FrWA14/KiCad10_RP2350B_DevelopmentBoard/Image/back.png

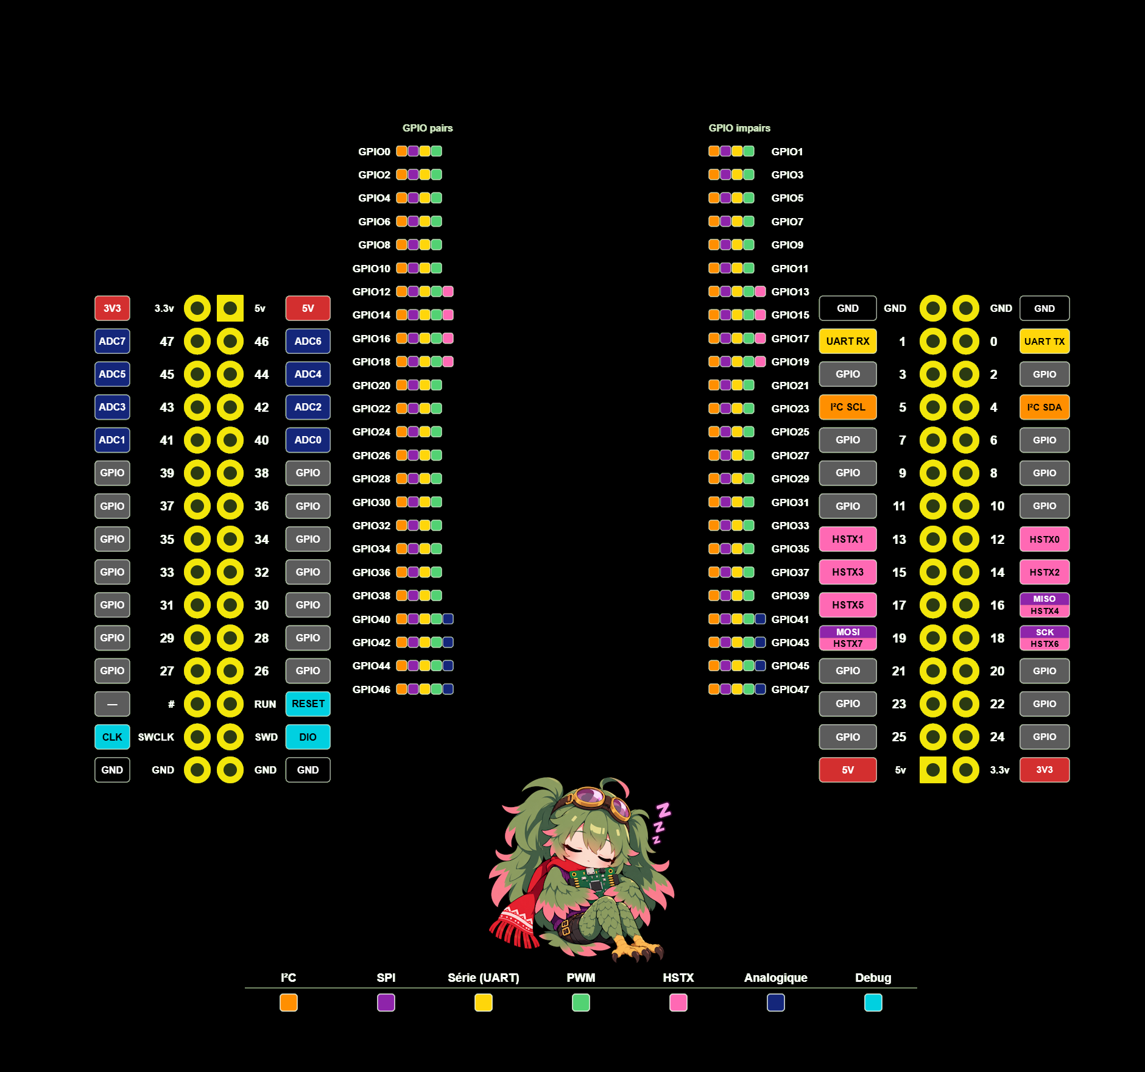
Image/back.png
