FrWA14/KiCad10_RP2350B_DevelopmentBoard/Image/PAC_Multimetre.png

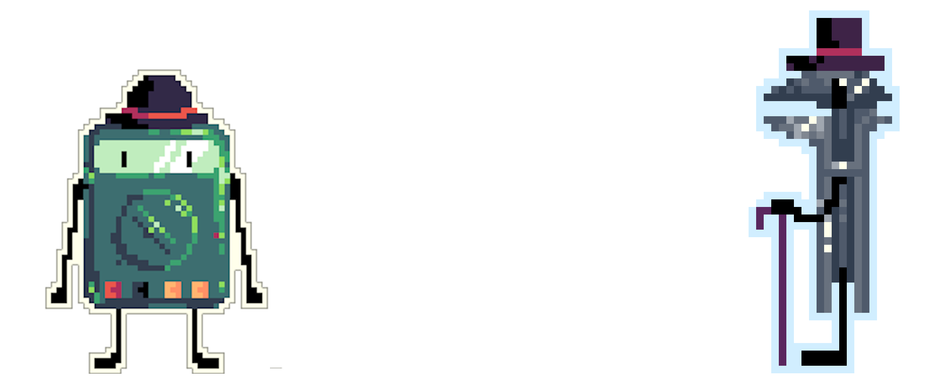
Image/PAC_Multimetre.png
