FrWA14/KiCad10_RP2350B_DevelopmentBoard/production/color_top_composite.png

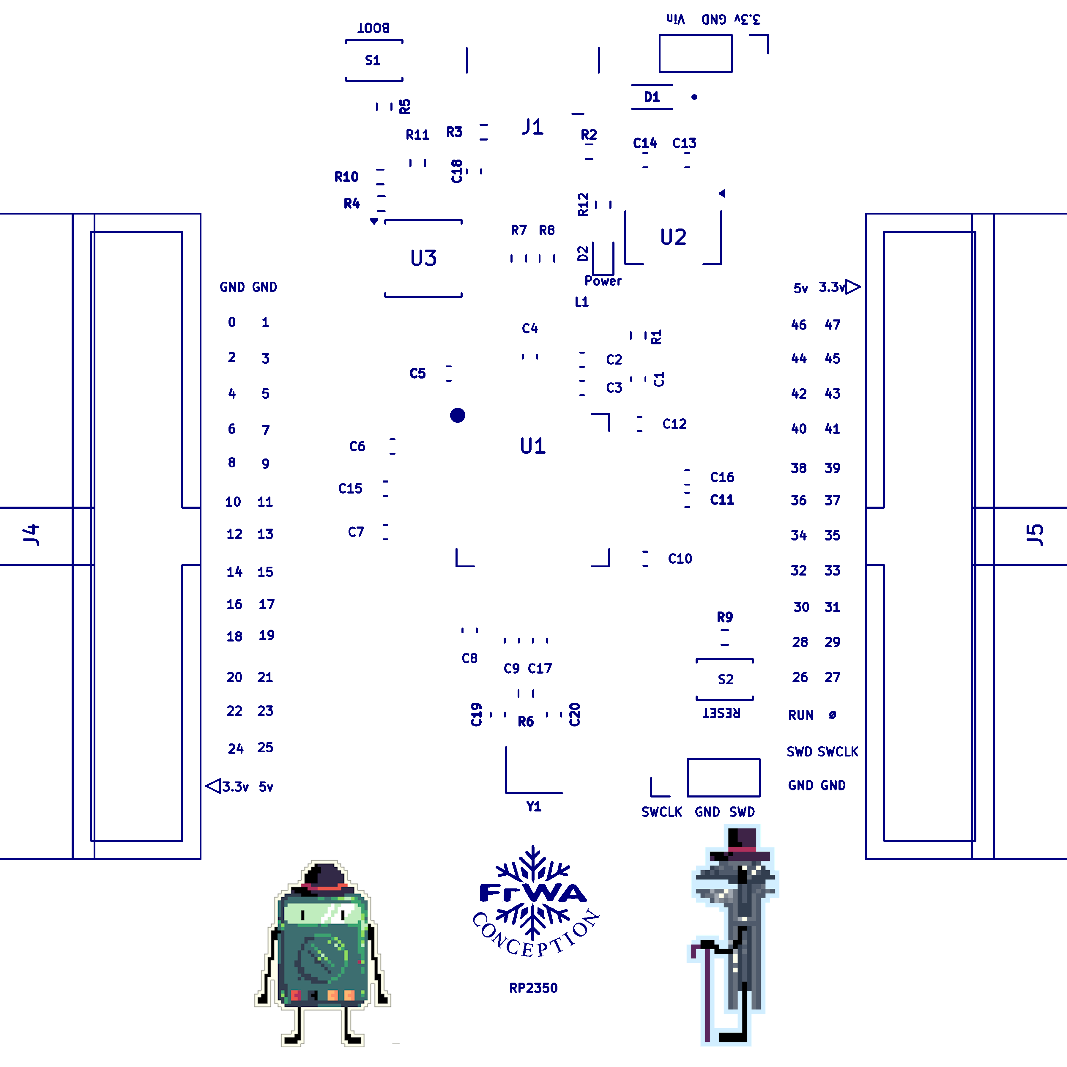
production/color_top_composite.png
