FrWA14/KiCad10_RP2350B_DevelopmentBoard/production/preview_top.png

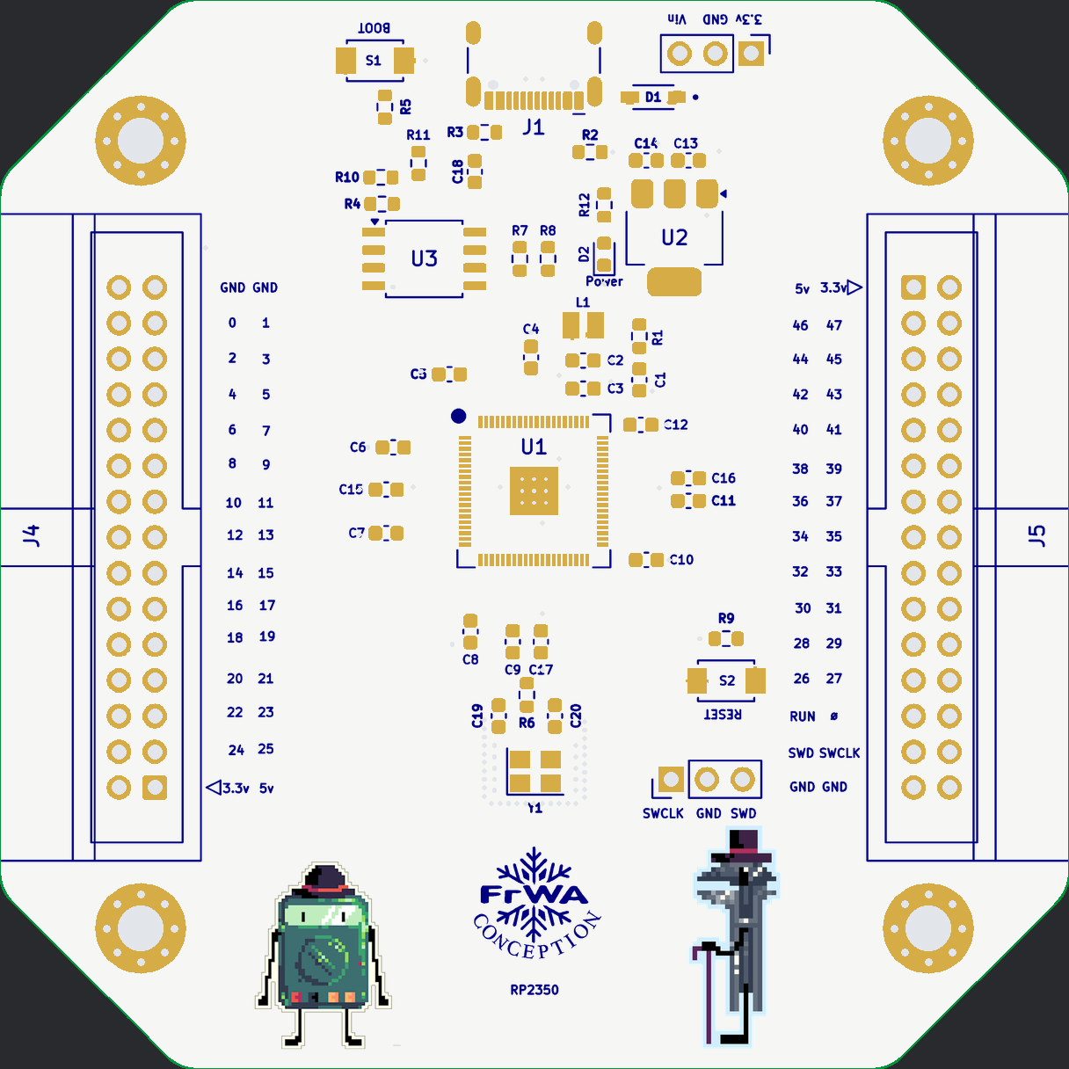
production/preview_top.png
