FrWA14/KiCad10_RP2350B_DevelopmentBoard/production/bom.csv

Designator | Footprint | Quantity | Value | LCSC Part #
C1, C17, C2, C3 | 0603 | 4 | 4.7uF | C19666
C10, C11, C12, C15, C16, C18, C4, C5, C6, C7, C8, C9 | 0603 | 12 | 100nF | C14663
C13, C14 | 0603 | 2 | 10uF | C1691
C19, C20 | 0603 | 2 | 15p | C1644
D1 | D_SOD-123_1N5819HW-7-F | 1 | 1N5819HW-7-F | C82544
D2 | 0603 | 1 | LED R | C965799
J1 | USB_C_Receptacle_HCTL_HC-TYPE-C-16P-01A | 1 | USB_C_Receptacle_USB2.0_16P | C393939
J2, J3 | PinHeader_1x03_P2.54mm_Vertical | 2 | Conn_01x03
J4, J5 | IDC-Header_2x15_P2.54mm_Horizontal_vertical | 2 | Conn_02x15_Odd_Even | C221084
L1 | 0806 | 1 | 3.3uH | C42411119
R1 | 0603 | 1 | 33 | C23140
R10, R4 | 0603 | 2 | DNF
R11 | 0603 | 1 | 0 | C21189
R12 | 0603 | 1 | 10k | C25804
R2, R3 | 0603 | 2 | 5.1K | C23186
R5, R6, R9 | 0603 | 3 | 1k | C21190
R7, R8 | 0603 | 2 | 27 | C137753
S1, S2 | SW_TS-1088-AR02016 | 2 | TS-1088-AR02016 | C720477
U1 | RP2350B_QFN-80_EP_10.573x10.573_Pitch0.4mm | 1 | RP2350B-QFN80 | C42415655
U2 | SOT-223-3_TabPin2 | 1 | AMS1117-3.3 | C6186
U3 | SOIC-8_5.23x5.23mm_P1.27mm | 1 | W25Q128JVS | C97521
Y1 | Crystal_SMD_3225-4Pin_3.2x2.5mm | 1 | Crystal_GND24 | C20625731
