FrWA14/KiCad10_RP2350B_DevelopmentBoard/RP2350.step

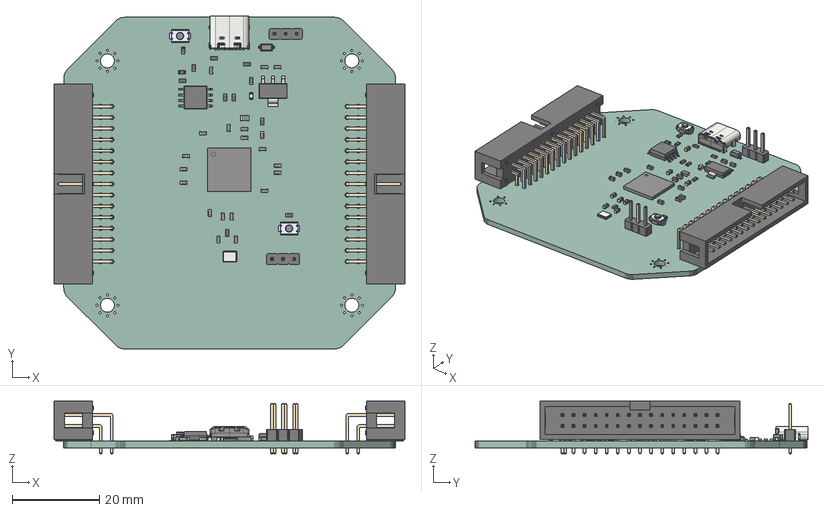
[picture p9: CAD file, 2026-10-22]
RP2350.step
80.4 x 76.3 x 12.1 mm
C_0603_1608Metric x 20
IDC_Header_2x15_P254mm_Horizontal x 2
PinHeader_1x03_P254mm_Vertical x 2
R_0603_1608Metric x 12
RP2350B-QFN80_v12
TS-1088-AR02016 x 2
SOT-223
L_0805_2012Metric
1N5819HW-7-F
Crystal_SMD_3225-4Pin_3.2x2.5mm
LED_0603_1608Metric
USB_C_Receptacle_16P_TopMnt_Horizontal_GCT_USB4105-xx-A
SOIC-8_5.3x5.3mm_P1.27mm
RP2350_PCB
