FrWA14/KiCad10_RP2350B_DevelopmentBoard/(list of files, cad)

Other CAD files:
RP2350.stl
