FrWA14/KiCad10_RP2350B_DevelopmentBoard/(list of files, drawings)

Other design files:
freerouting.dsn
