FrWA14/KiCad10_RP2350B_DevelopmentBoard/RP2350.kicad_pcb

## KiCad design RP2350.kicad_pcb (2026-10-22)

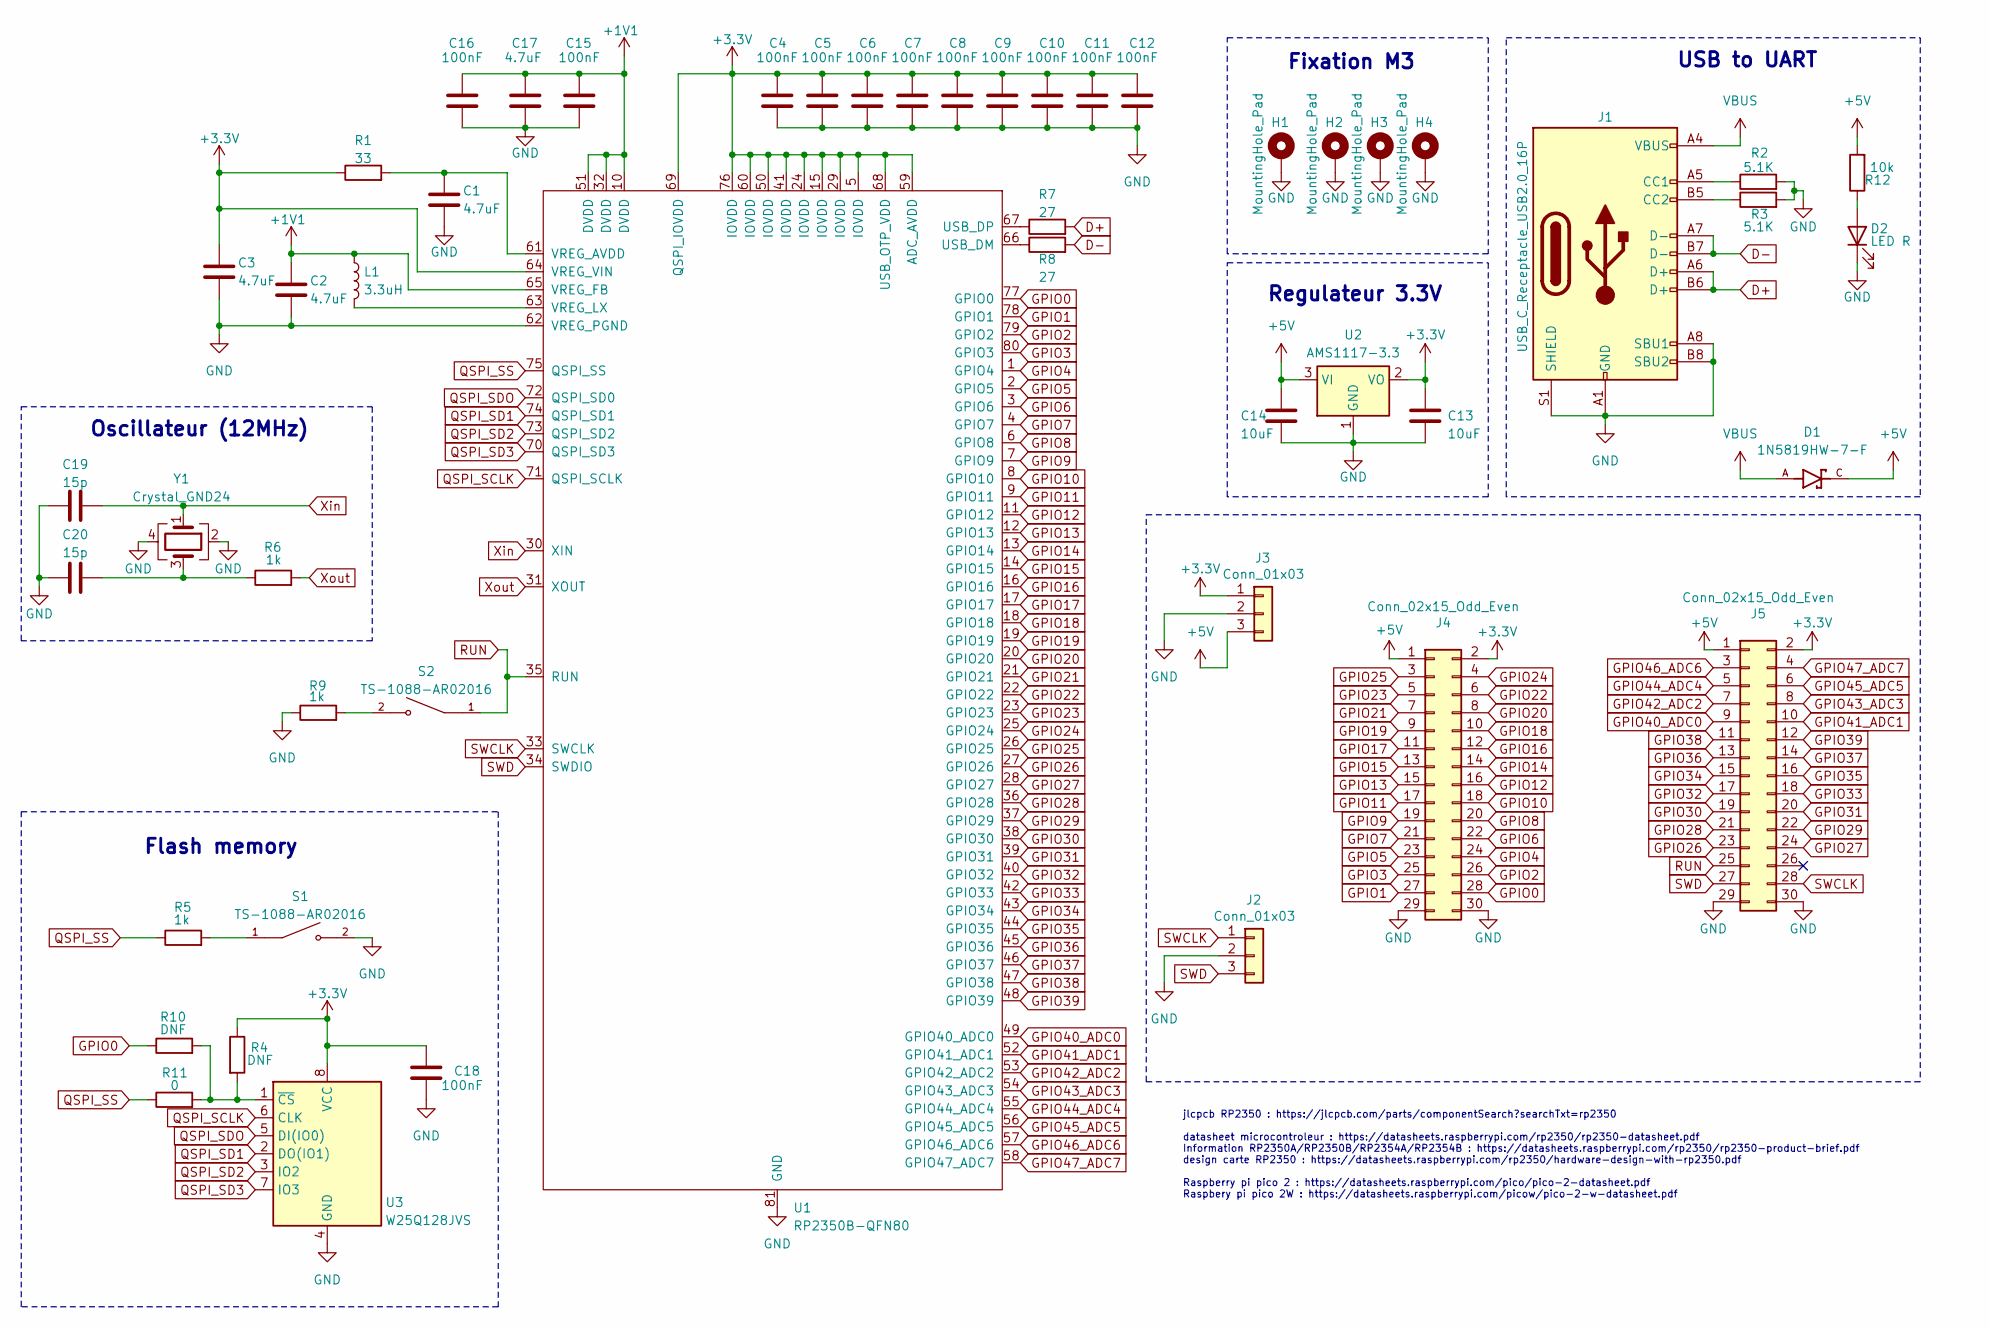
[picture p10: schematic RP2350.kicad_sch]

Parts:
C1, C2, C3, C17: 4.7uF; C_0603_1608Metric; JLCPCB Part # C19666
C4, C5, C6, C7, C8, C9, C10, C11, C12, C15, C16, C18: 100nF; C_0603_1608Metric; JLCPCB Part # C14663
C13, C14: 10uF; C_0603_1608Metric; JLCPCB Part # C1691
C19, C20: 15p; C_0603_1608Metric; JLCPCB Part # C1644
D1: 1N5819HW-7-F; D_SOD-123_1N5819HW-7-F; PARTREV 18-2; JLCPCB Part # C82544
D2: LED R; LED_0603_1608Metric; JLCPCB Part # C965799
H1, H2, H3, H4: MountingHole_Pad; MountingHole_3.2mm_M3_Pad_Via
J1: USB_C_Receptacle_USB2.0_16P; USB_C_Receptacle_HCTL_HC-TYPE-C-16P-01A; JLCPCB Part # C393939
J2, J3: Conn_01x03; PinHeader_1x03_P2.54mm_Vertical
J4, J5: Conn_02x15_Odd_Even; IDC-Header_2x15_P2.54mm_Horizontal_vertical; JLCPCB Part # C221084
L1: 3.3uH; L_0806_2016Metric; JLCPCB Part # C42411119
R1: 33; R_0603_1608Metric; JLCPCB Part # C23140
R2, R3: 5.1K; R_0603_1608Metric; JLCPCB Part # C23186
R4, R10: DNF; R_0603_1608Metric
R5, R6, R9: 1k; R_0603_1608Metric; JLCPCB Part # C21190
R7, R8: 27; R_0603_1608Metric; JLCPCB Part # C137753
R11: 0; R_0603_1608Metric; JLCPCB Part # C21189
R12: 10k; R_0603_1608Metric; JLCPCB Part # C25804
S1, S2: TS-1088-AR02016; SW_TS-1088-AR02016; PARTREV N/A; JLCPCB Part # C720477
U1: RP2350B-QFN80; RP2350B_QFN-80_EP_10.573x10.573_Pitch0.4mm; JLCPCB Part # C42415655
U2: AMS1117-3.3; SOT-223-3_TabPin2; JLCPCB Part # C6186
U3: W25Q128JVS; SOIC-8_5.23x5.23mm_P1.27mm; JLCPCB Part # C97521
Y1: Crystal_GND24; Crystal_SMD_3225-4Pin_3.2x2.5mm; JLCPCB Part # C20625731

Connections:
+1V1: C2.1, C15.1, C16.1, C17.1, L1.1, U1.10 (DVDD), U1.32 (DVDD), U1.51 (DVDD), U1.65 (VREG_FB)
+3.3V: C3.1, C4.1, C5.1, C6.1, C7.1, C8.1, C9.1, C10.1, C11.1, C12.1, C13.1, C18.1, J3.1, J4.2, J5.2, R1.1, R4.1, U1.5 (IOVDD), U1.15 (IOVDD), U1.24 (IOVDD), U1.29 (IOVDD), U1.41 (IOVDD), U1.50 (IOVDD), U1.59 (ADC_AVDD), U1.60 (IOVDD), U1.64 (VREG_VIN), U1.68 (USB_OTP_VDD), U1.69 (QSPI_IOVDD), U1.76 (IOVDD), U2.2 (VO), U3.8 (VCC)
+5V: C14.1, D1.C, J3.3, J4.1, J5.1, R12.2, U2.3 (VI)
D+: J1.A6 (D+), J1.B6 (D+), R7.2
D-: J1.A7 (D-), J1.B7 (D-), R8.2
GND: C1.2, C2.2, C3.2, C4.2, C5.2, C6.2, C7.2, C8.2, C9.2, C10.2, C11.2, C12.2, C13.2, C14.2, C15.2, C16.2, C17.2, C18.2, C19.1, C20.1, D2.1 (K), H1.1 (1_1), H2.1 (1_1), H3.1 (1_1), H4.1 (1_1), J1.A1 (GND), J1.A8 (SBU1), J1.A12 (GND), J1.B1 (GND), J1.B8 (SBU2), J1.B12 (GND), J1.S1 (SHIELD), J2.2, J3.2, J4.29, J4.30, J5.29, J5.30, R2.2, R3.2, R9.1, S1.2, U1.62 (VREG_PGND), U1.81 (GND), U2.1 (GND), U3.4 (GND), Y1.2, Y1.4
GPIO0: J4.28, R10.1, U1.77 (GPIO0)
GPIO1: J4.27, U1.78 (GPIO1)
GPIO2: J4.26, U1.79 (GPIO2)
GPIO3: J4.25, U1.80 (GPIO3)
GPIO4: J4.24, U1.1 (GPIO4)
GPIO5: J4.23, U1.2 (GPIO5)
GPIO6: J4.22, U1.3 (GPIO6)
GPIO7: J4.21, U1.4 (GPIO7)
GPIO8: J4.20, U1.6 (GPIO8)
GPIO9: J4.19, U1.7 (GPIO9)
GPIO10: J4.18, U1.8 (GPIO10)
GPIO11: J4.17, U1.9 (GPIO11)
GPIO12: J4.16, U1.11 (GPIO12)
GPIO13: J4.15, U1.12 (GPIO13)
GPIO14: J4.14, U1.13 (GPIO14)
GPIO15: J4.13, U1.14 (GPIO15)
GPIO16: J4.12, U1.16 (GPIO16)
GPIO17: J4.11, U1.17 (GPIO17)
GPIO18: J4.10, U1.18 (GPIO18)
GPIO19: J4.9, U1.19 (GPIO19)
GPIO20: J4.8, U1.20 (GPIO20)
GPIO21: J4.7, U1.21 (GPIO21)
GPIO22: J4.6, U1.22 (GPIO22)
GPIO23: J4.5, U1.23 (GPIO23)
GPIO24: J4.4, U1.25 (GPIO24)
GPIO25: J4.3, U1.26 (GPIO25)
GPIO26: J5.23, U1.27 (GPIO26)
GPIO27: J5.24, U1.28 (GPIO27)
GPIO28: J5.21, U1.36 (GPIO28)
GPIO29: J5.22, U1.37 (GPIO29)
GPIO30: J5.19, U1.38 (GPIO30)
GPIO31: J5.20, U1.39 (GPIO31)
GPIO32: J5.17, U1.40 (GPIO32)
GPIO33: J5.18, U1.42 (GPIO33)
GPIO34: J5.15, U1.43 (GPIO34)
GPIO35: J5.16, U1.44 (GPIO35)
GPIO36: J5.13, U1.45 (GPIO36)
GPIO37: J5.14, U1.46 (GPIO37)
GPIO38: J5.11, U1.47 (GPIO38)
GPIO39: J5.12, U1.48 (GPIO39)
GPIO40_ADC0: J5.9, U1.49 (GPIO40_ADC0)
GPIO41_ADC1: J5.10, U1.52 (GPIO41_ADC1)
GPIO42_ADC2: J5.7, U1.53 (GPIO42_ADC2)
GPIO43_ADC3: J5.8, U1.54 (GPIO43_ADC3)
GPIO44_ADC4: J5.5, U1.55 (GPIO44_ADC4)
GPIO45_ADC5: J5.6, U1.56 (GPIO45_ADC5)
GPIO46_ADC6: J5.3, U1.57 (GPIO46_ADC6)
GPIO47_ADC7: J5.4, U1.58 (GPIO47_ADC7)
unnamed: C20.2, R6.1, Y1.3
unnamed: D2.2 (A), R12.1
unnamed: J1.A5 (CC1), R2.1
unnamed: J1.B5 (CC2), R3.1
unnamed: R5.2, S1.1
unnamed: R9.2, S2.2
unnamed: R8.1, U1.66 (USB_DM)
unnamed: R7.1, U1.67 (USB_DP)
unnamed: C1.1, R1.2, U1.61 (VREG_AVDD)
unnamed: L1.2, U1.63 (VREG_LX)
unnamed: R4.2, R10.2, R11.2, U3.1 (~CS)
QSPI_SCLK: U1.71 (QSPI_SCLK), U3.6 (CLK)
QSPI_SD1: U1.74 (QSPI_SD1), U3.2 (DO(IO1))
QSPI_SD2: U1.73 (QSPI_SD2), U3.3 (IO2)
QSPI_SD3: U1.70 (QSPI_SD3), U3.7 (IO3)
QSPI_SDO: U1.72 (QSPI_SD0), U3.5 (DI(IO0))
QSPI_SS: R5.1, R11.1, U1.75 (QSPI_SS)
RUN: J5.25, S2.1, U1.35 (RUN)
SWCLK: J2.1, J5.28, U1.33 (SWCLK)
SWD: J2.3, J5.27, U1.34 (SWDIO)
VBUS: D1.A, J1.A4 (VBUS), J1.A9 (VBUS), J1.B4 (VBUS), J1.B9 (VBUS)
Xin: C19.2, U1.30 (XIN), Y1.1
Xout: R6.2, U1.31 (XOUT)

Notes on the sheet:
USB to UART
Flash memory
jlcpcb RP2350 : https://jlcpcb.com/parts/componentSearch?searchTxt=rp2350 datasheet microcontroleur : https://datasheets.raspberrypi.com/rp2350/rp2350-datasheet.pdf Information RP2350A/RP2350B/RP2354A/RP2354B : https://datasheets.raspberrypi.com/rp2350/rp2350-product-brief.pdf design carte RP2350 :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
Fixation M3
Regulateur 3.3V
Oscillateur (12MHz)

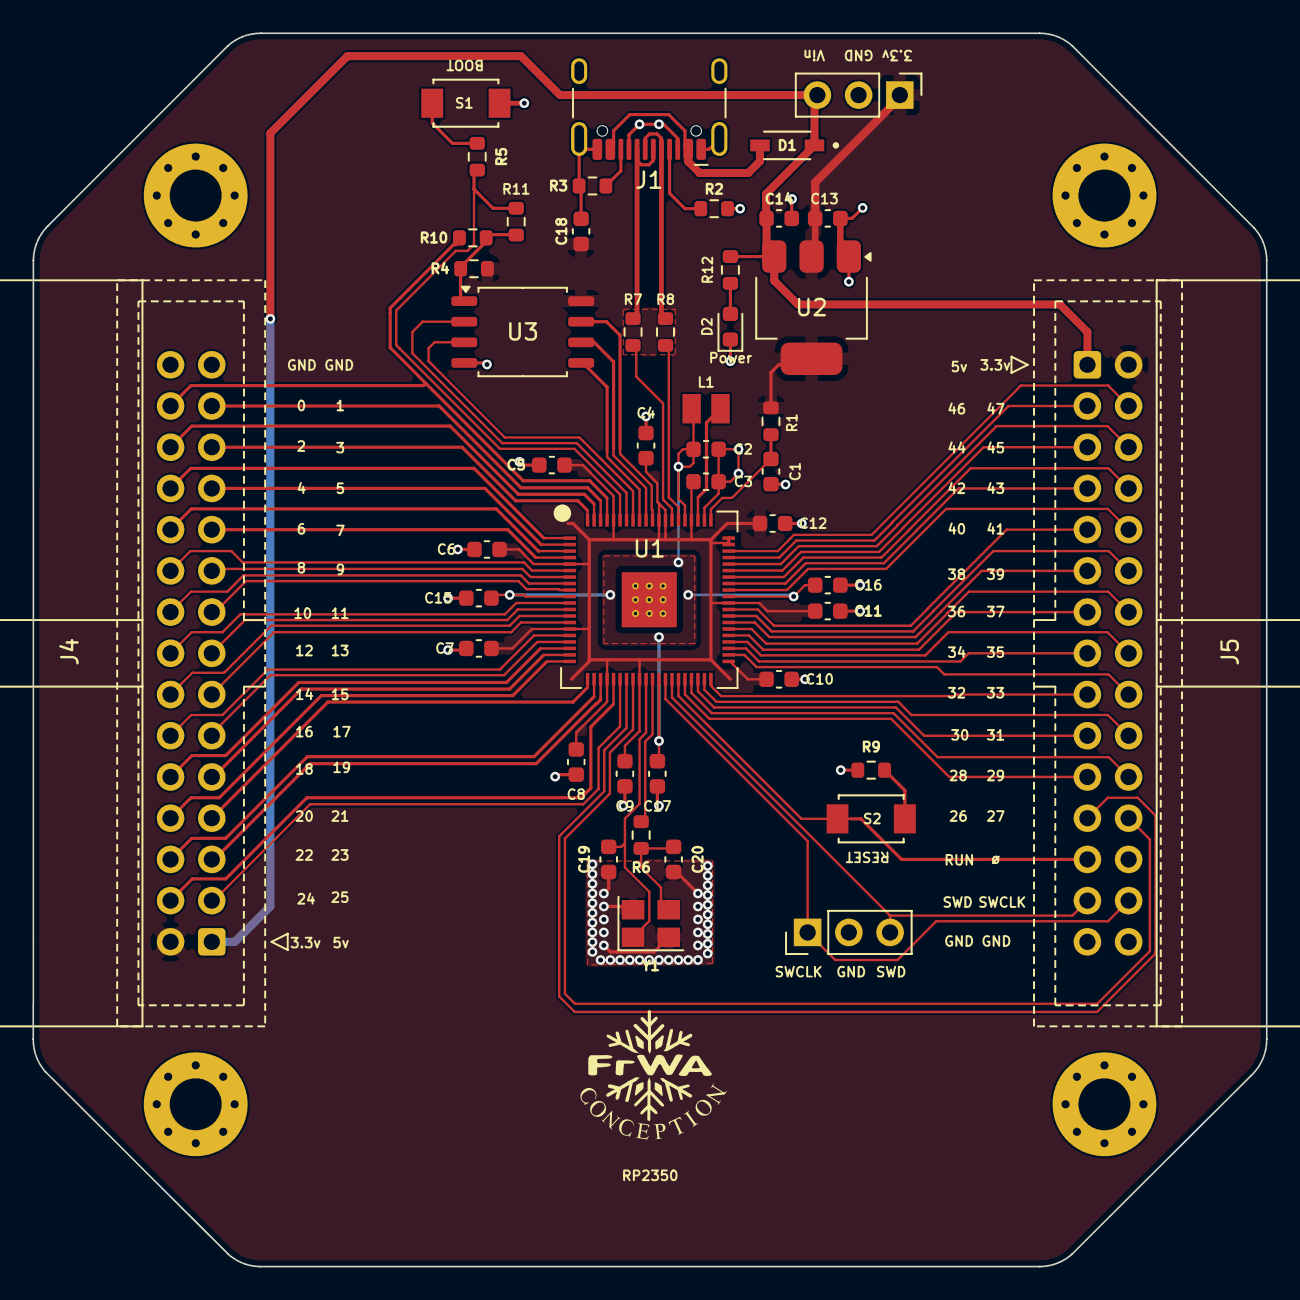
[picture p11: board RP2350.kicad_pcb from above]

Board: 2 copper layers, 76.0 x 76.0 mm, 50 parts (0 on the bottom side), 77 nets.
