FrWA14/KiCad10_RP2350B_DevelopmentBoard/(commit log)

2026-10-22 Carte de développement RP2350B sous KiCad 10
    Projet autonome : symboles, empreintes et modèles 3D dans libs/,
    liés en chemin relatif (${KIPRJMOD}). Fichiers de fabrication JLCPCB
    avec sérigraphie couleur dans production/.
    [RP2350.kicad_pcb, RP2350.kicad_sch, bom.csv, designators.csv, freerouting.dsn, positions.csv]
2026-10-22 Modèle 3D de L1 (0805) et export 3D de la carte
    RP2350.step pour les logiciels de CAO, RP2350.stl visible en 3D sur GitHub.
    [RP2350.kicad_pcb, RP2350.step, RP2350.stl]
2026-10-22 Rétablit les captures KiCad du README et ses fins de ligne
    Le commit précédent avait enregistré par erreur la suppression locale des
    trois captures et converti le README en LF.
